voychenko-v/logger-stm32f401/hardware/Screenshot 2026-11-09 164255.png

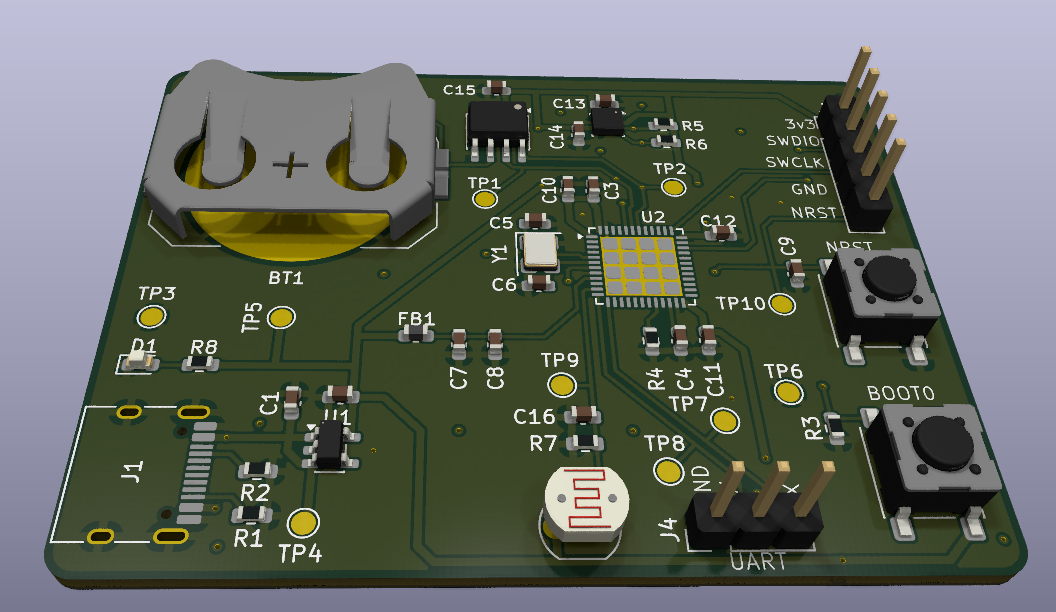
hardware/Screenshot 2026-11-09 164255.png
