voychenko-v/logger-stm32f401/hardware/env-logger.csv

Id | Designator | Footprint | Quantity | Designation | Supplier and ref
1 | BT1 | BatteryHolder_Keystone_3034_1x20mm | 1 | Battery_Cell
2 | C1, C2, C8 | C_0603_1608Metric | 3 | 1 мкФ
3 | C3, C7, C9, C10, C11, C12, C13, C14, C15, C16 | C_0603_1608Metric | 10 | 100 нФ
4 | C4 | C_0603_1608Metric | 1 | 2,2 мкФ
5 | C5, C6 | C_0603_1608Metric | 2 | 15 пФ
6 | D1 | LED_0603_1608Metric | 1 | LED
7 | FB1 | L_0603_1608Metric | 1 | FerriteBead
8 | J1 | USB_C_Receptacle_HRO_TYPE-C-31-M-12 | 1 | USB_C_USB2.0_14P
9 | J3 | PinHeader_1x05_P2.54mm_Vertical | 1 | Conn_01x05
10 | J4 | PinHeader_1x03_P2.54mm_Vertical | 1 | Conn_01x03
11 | R1, R2 | R_0603_1608Metric | 2 | 5,1 кОм
12 | R3, R4, R7 | R_0603_1608Metric | 3 | 10 кОм
13 | R5, R6 | R_0603_1608Metric | 2 | 4,7 кОм
14 | R8 | R_0603_1608Metric | 1 | 1 кОм
15 | R9 | R_LDR_5.0x4.1mm_P3mm_Vertical | 1 | GL5516
16 | SW1, SW2 | SW_SPST_PTS645Sx43SMTR92 | 2 | SW_Push
17 | TP1, TP2, TP3, TP4, TP5, TP6, TP7, TP8, TP9, TP10 | TestPoint_Pad_D1.5mm | 10 | TestPoint
18 | U1 | SOT-23-5 | 1 | AP2112K-3.3
19 | U2 | QFN-48-1EP_7x7mm_P0.5mm_EP5.6x5.6mm | 1 | STM32F401CCUx
20 | U3 | Bosch_LGA-8_2.5x2.5mm_P0.65mm_ClockwisePinNumbering | 1 | BME280
21 | U4 | SOIC-8_3.9x4.9mm_P1.27mm | 1 | DS3231MZ
22 | Y1 | Crystal_SMD_3225-4Pin_3.2x2.5mm | 1 | 25 МГц
