voychenko-v/logger-stm32f401/hardware/shematic.pdf

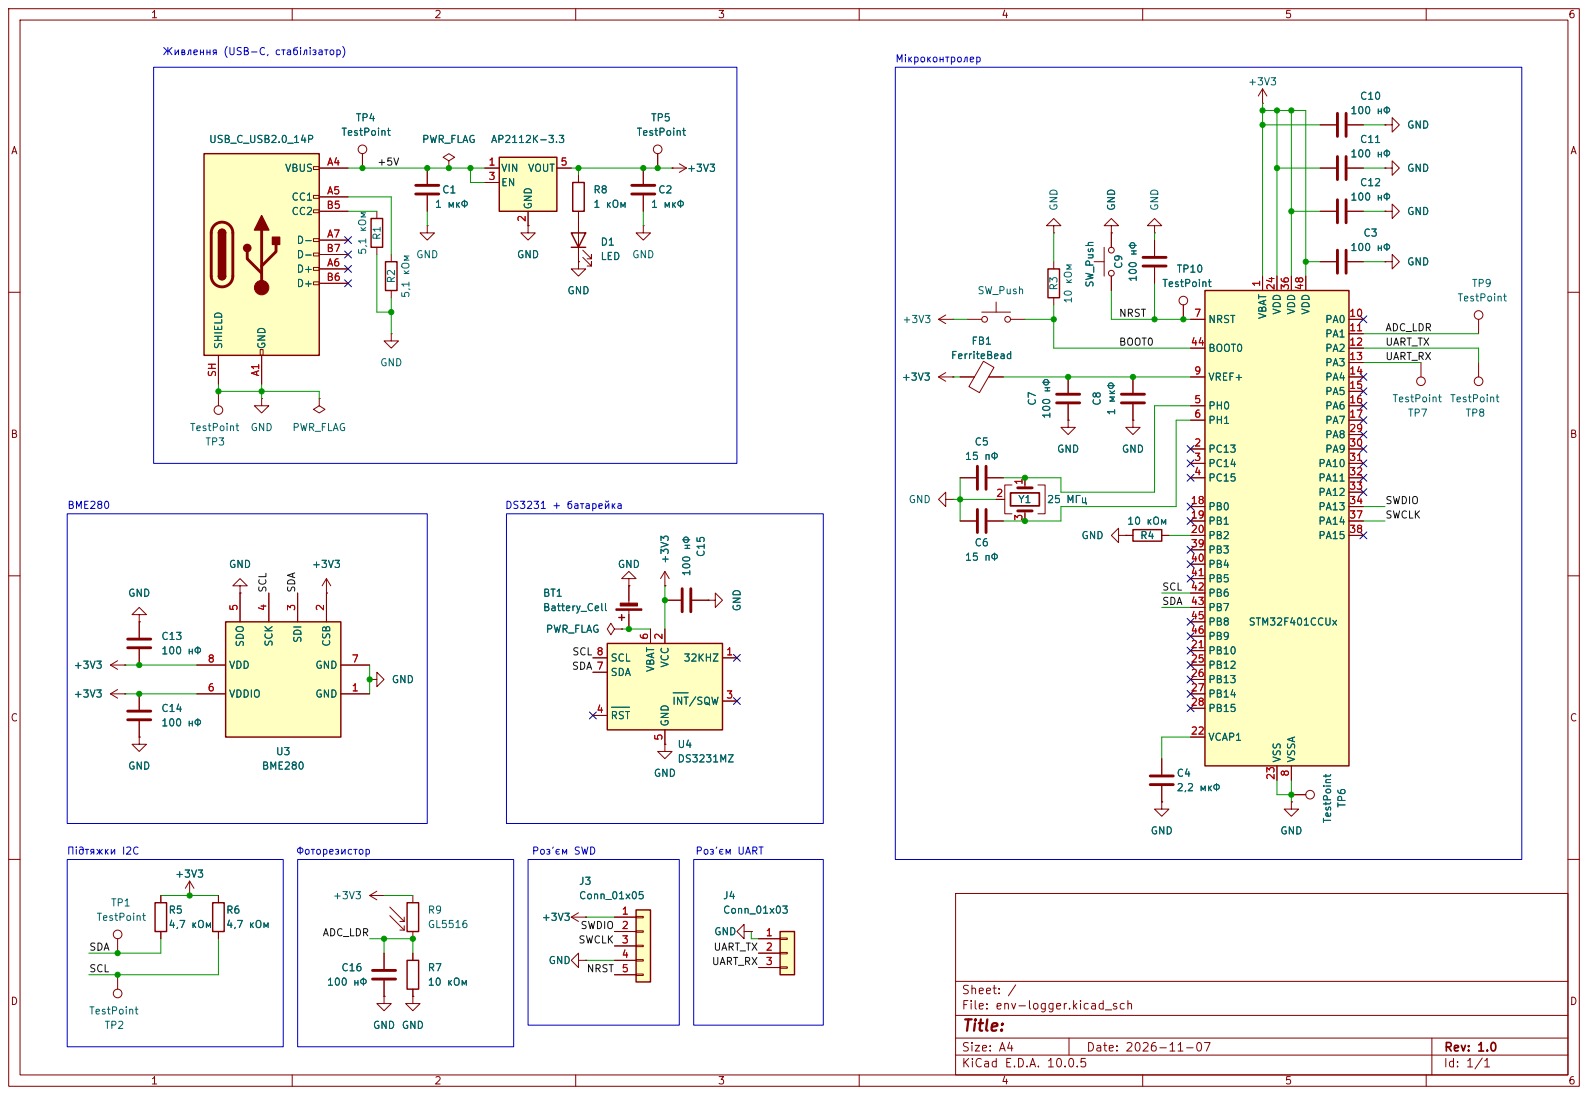
[picture p3: page 1]

Мікроконтролер Живлення (USB-C, стабілізатор)

SDA SCL

Size: A4 | Rev: 1.0
KiCad E.D.A. 10.0.5 | Id: 1/1
