voychenko-v/logger-stm32f401/hardware/env-logger-schematic.pdf

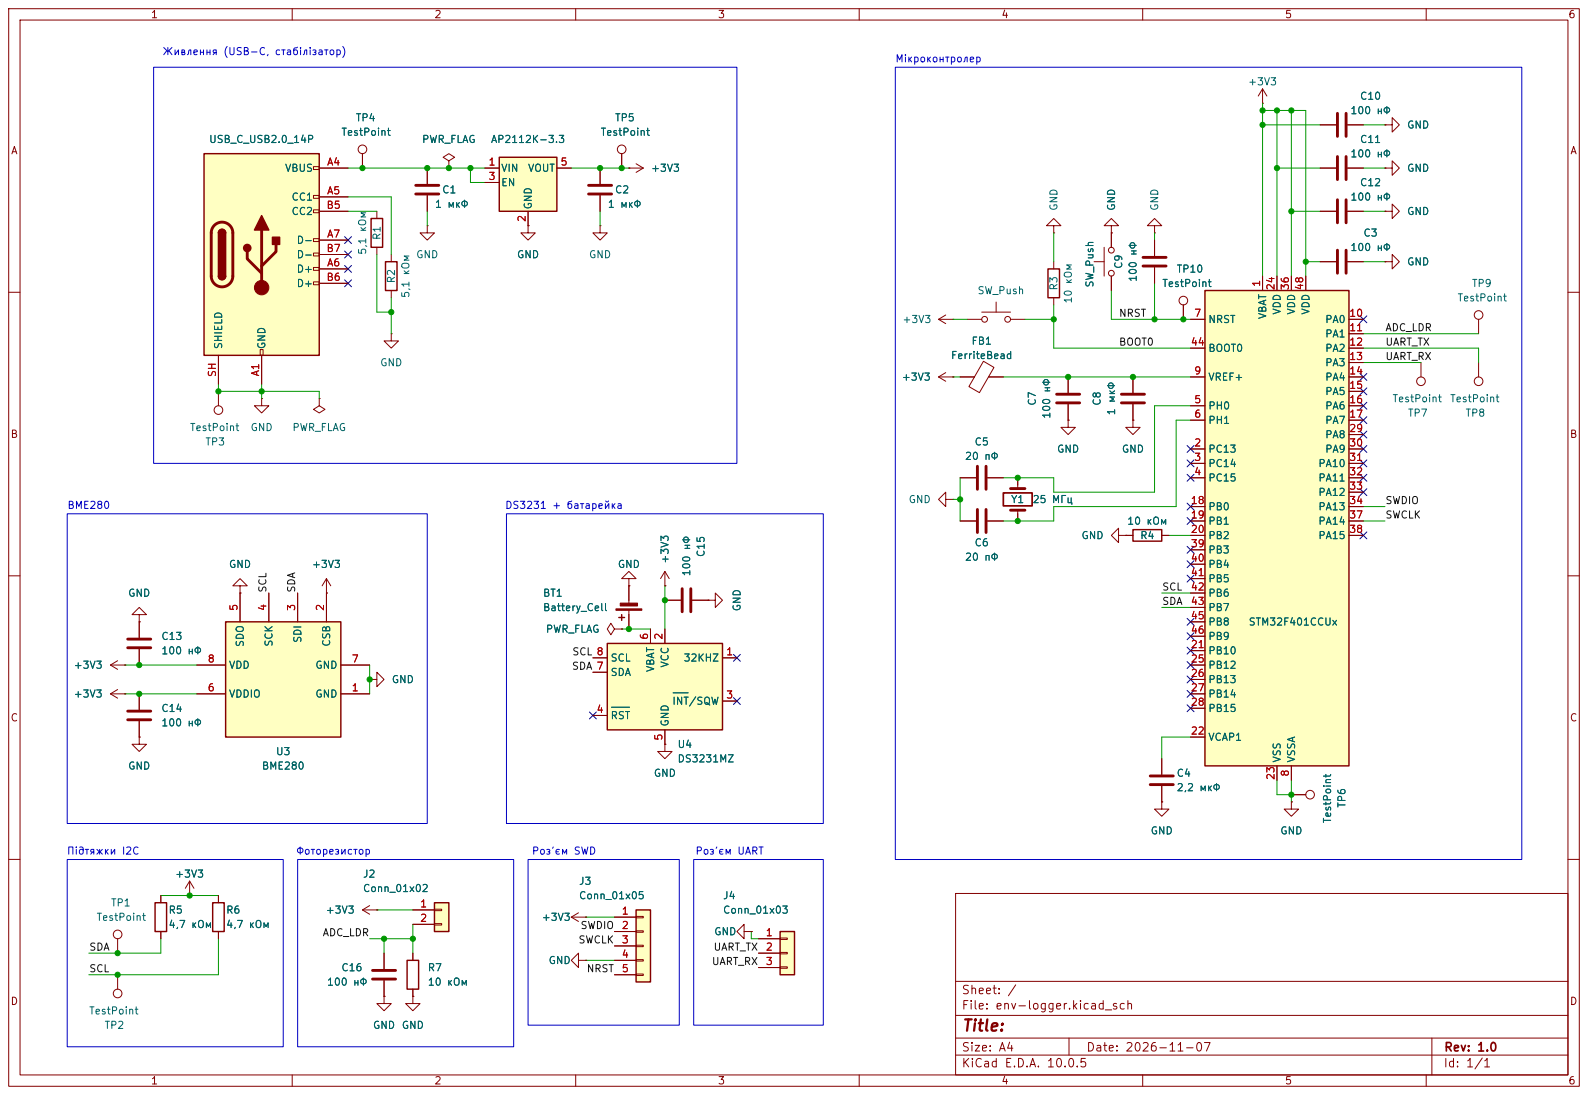
[picture p4: page 1]

Size: A4 | Rev: 1.0
KiCad E.D.A. 10.0.5 | Id: 1/1
