voychenko-v/logger-stm32f401/hardware/env-logger/env-logger.kicad_pcb

## KiCad design hardware/env-logger/env-logger.kicad_pcb (2026-11-10)

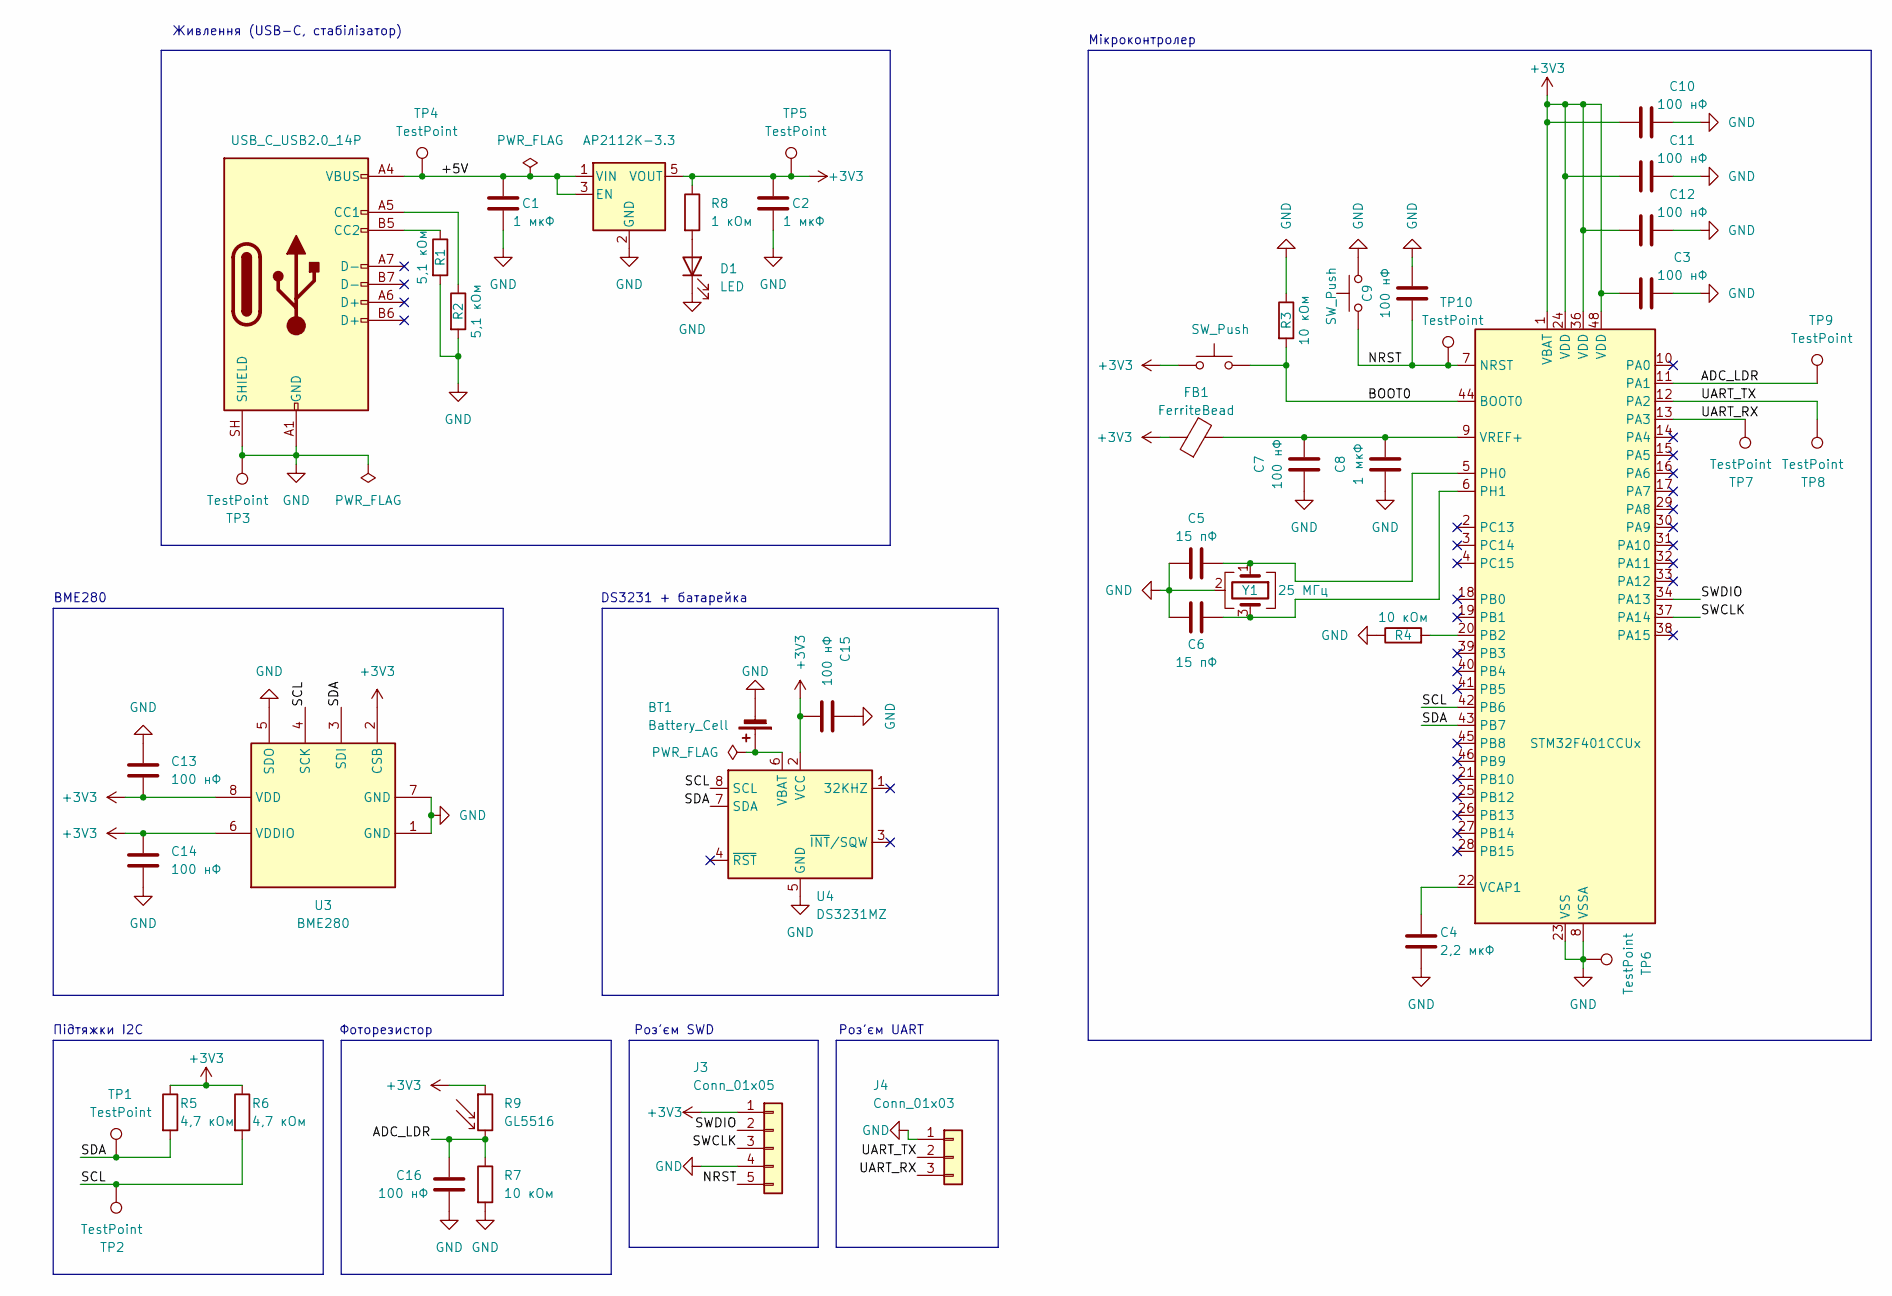
[picture p5: schematic env-logger.kicad_sch]

Parts:
BT1: Battery_Cell; BatteryHolder_Keystone_3034_1x20mm
C1, C2, C8: 1 мкФ; C_0603_1608Metric
C3, C7, C9, C10, C11, C12, C13, C14, C15, C16: 100 нФ; C_0603_1608Metric
C4: 2,2 мкФ; C_0603_1608Metric
C5, C6: 15 пФ; C_0603_1608Metric
D1: LED; LED_0603_1608Metric
FB1: FerriteBead; L_0603_1608Metric
J1: USB_C_USB2.0_14P; USB_C_Receptacle_HRO_TYPE-C-31-M-12
J3: Conn_01x05; PinHeader_1x05_P2.54mm_Vertical
J4: Conn_01x03; PinHeader_1x03_P2.54mm_Vertical
R1, R2: 5,1 кОм; R_0603_1608Metric
R3, R4, R7: 10 кОм; R_0603_1608Metric
R5, R6: 4,7 кОм; R_0603_1608Metric
R8: 1 кОм; R_0603_1608Metric
R9: GL5516; R_LDR_5.0x4.1mm_P3mm_Vertical
SW1, SW2: SW_Push; SW_SPST_PTS645Sx43SMTR92
TP1, TP2, TP3, TP4, TP5, TP6, TP7, TP8, TP9, TP10: TestPoint; TestPoint_Pad_D1.5mm
U1: AP2112K-3.3; SOT-23-5
U2: STM32F401CCUx; QFN-48-1EP_7x7mm_P0.5mm_EP5.6x5.6mm
U3: BME280; Bosch_LGA-8_2.5x2.5mm_P0.65mm_ClockwisePinNumbering
U4: DS3231MZ; SOIC-8_3.9x4.9mm_P1.27mm
Y1: 25 МГц; Crystal_SMD_3225-4Pin_3.2x2.5mm

Connections:
+3V3: C2.1, C3.1, C10.1, C11.1, C12.1, C13.2, C14.1, C15.2, FB1.1, J3.1, R5.1, R6.1, R8.1, R9.1, SW1.1, TP5.1 (1_1), U1.5 (VOUT), U2.1 (VBAT), U2.24 (VDD), U2.36 (VDD), U2.48 (VDD), U3.2 (CSB), U3.6 (VDDIO), U3.8 (VDD), U4.2 (VCC)
/+5V: C1.1, J1.A4 (VBUS), J1.A9 (VBUS), J1.B4 (VBUS), J1.B9 (VBUS), TP4.1 (1_1), U1.1 (VIN), U1.3 (EN)
/ADC_LDR: C16.1, R7.1, R9.2, TP9.1 (1_1), U2.11 (PA1)
/BOOT0: R3.2, SW1.2, U2.44 (BOOT0)
/NRST: C9.1, J3.5, SW2.1, TP10.1 (1_1), U2.7 (NRST)
/SCL: R6.2, TP2.1 (1_1), U2.42 (PB6), U3.4 (SCK), U4.8 (SCL)
/SDA: R5.2, TP1.1 (1_1), U2.43 (PB7), U3.3 (SDI), U4.7 (SDA)
/SWCLK: J3.3, U2.37 (PA14)
/SWDIO: J3.2, U2.34 (PA13)
/UART_RX: J4.3, TP7.1 (1_1), U2.13 (PA3)
/UART_TX: J4.2, TP8.1 (1_1), U2.12 (PA2)
GND: BT1.2 (-), C1.2, C2.2, C3.2, C4.2, C5.2, C6.2, C7.2, C8.2, C9.2, C10.2, C11.2, C12.2, C13.1, C14.2, C15.1, C16.2, D1.1 (K), J1.A1 (GND), J1.A12 (GND), J1.B1 (GND), J1.B12 (GND), J1.SH (SHIELD), J3.4, J4.1, R1.2, R2.2, R3.1, R4.1, R7.2, SW2.2, TP3.1 (1_1), TP6.1 (1_1), U1.2 (GND), U2.8 (VSSA), U2.23 (VSS), U2.35 (VSS), U2.47 (VSS), U2.49 (VSS), U3.1 (GND), U3.5 (SDO), U3.7 (GND), U4.5 (GND), Y1.2 (G), Y1.4 (G)
unnamed: BT1.1 (+), U4.6 (VBAT)
unnamed: D1.2 (A), R8.2
unnamed: J1.A5 (CC1), R2.1
unnamed: J1.B5 (CC2), R1.1
unnamed: R4.2, U2.20 (PB2)
unnamed: C5.1, U2.5 (PH0), Y1.1
unnamed: C6.1, U2.6 (PH1), Y1.3
unnamed: C4.1, U2.22 (VCAP1)
unnamed: C7.1, C8.1, FB1.2, U2.9 (VREF+)

Notes on the sheet:
Живлення (USB-C, стабілізатор)
Мікроконтролер
Роз'єм UART
DS3231 + батарейка
Роз'єм SWD
Підтяжки I2C
Фоторезистор
BME280

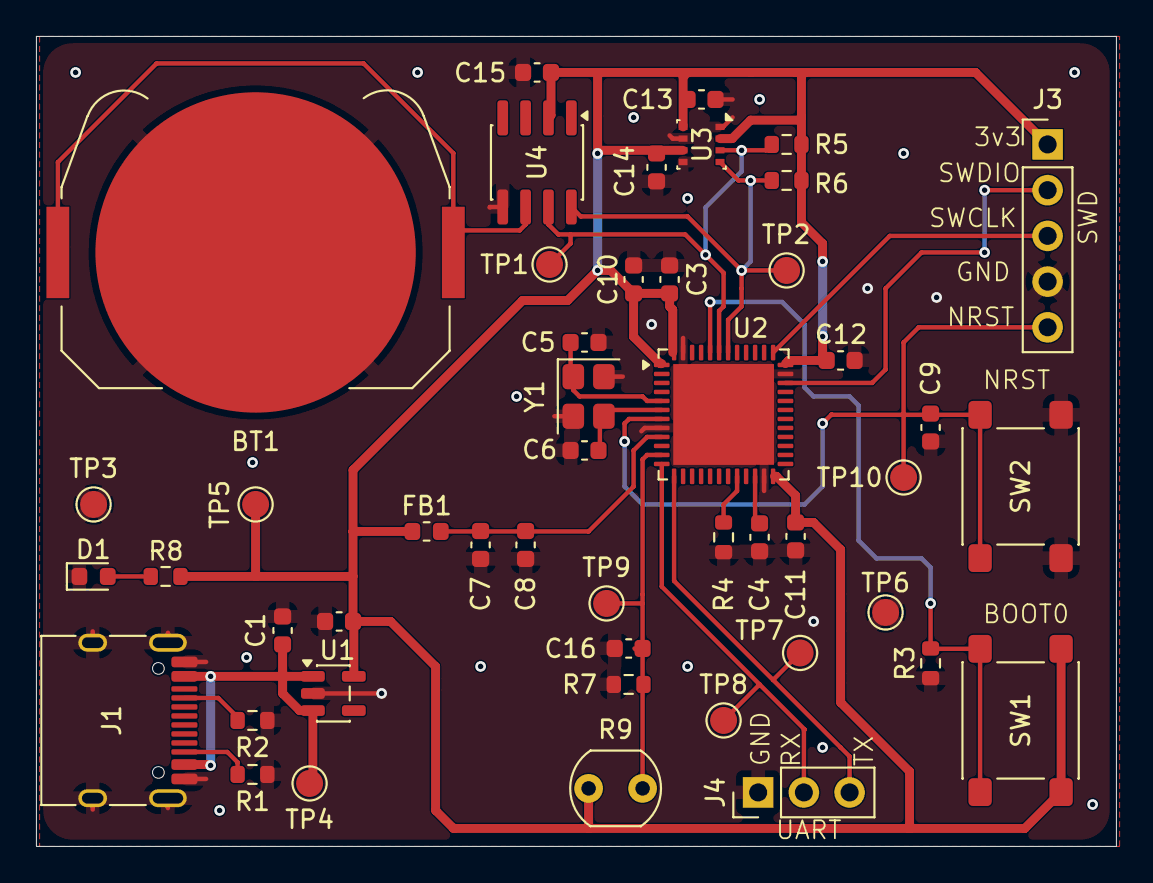
[picture p6: board env-logger.kicad_pcb from above]

Board: 2 copper layers, 60.0 x 45.0 mm, 48 parts (0 on the bottom side), 21 nets.
