voychenko-v/logger-stm32f401/Core/Src/main.c

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
/* Includes ------------------------------------------------------------------*/
#include "main.h"
#include "adc.h"
#include "dma.h"
#include "i2c.h"
#include "iwdg.h"
#include "tim.h"
#include "usart.h"
#include "gpio.h"

/* USER CODE BEGIN Includes */
#include <stdio.h>
#include "uart_log.h"
#include "i2c_bus.h"
#include "ds3231.h"
#include "bme280.h"
#include "logger.h"
#include "reset_info.h"
#include "watchdog.h"
#include "uart_rx.h"
#include "cli.h"
/* USER CODE END Includes */


void SystemClock_Config(void);
/**
  * @brief  The application entry point.
  * @retval int
  */
int main(void)
{

  /* MCU Configuration--------------------------------------------------------*/

  /* Reset of all peripherals, Initializes the Flash interface and the Systick. */
  HAL_Init();

  /* USER CODE BEGIN Init */
	__HAL_DBGMCU_FREEZE_IWDG();
  /* USER CODE END Init */

  /* Configure the system clock */
  SystemClock_Config();

  /* Initialize all configured peripherals */
  MX_GPIO_Init();
  MX_DMA_Init();
  MX_USART2_UART_Init();
  MX_TIM3_Init();
  MX_I2C1_Init();
  MX_IWDG_Init();
  MX_ADC1_Init();
  /* USER CODE BEGIN 2 */
	uart_log_init(&huart2);
	printf("\r\n=== Env Logger started ===\r\n");
	printf("SYSCLK = %lu Hz\r\n", HAL_RCC_GetSysClockFreq());
	printf("Reset reason: %s\r\n", reset_info_name(reset_info_get_and_clear()));

	watchdog_kick();
	i2c_bus_scan(&hi2c1);
	watchdog_kick();
	logger_init();
	uart_rx_init(&huart2);
	watchdog_kick();
	HAL_TIM_Base_Start_IT(&htim3);
  /* USER CODE END 2 */

  /* Infinite loop */
  /* USER CODE BEGIN WHILE */
	while (1) {
    /* USER CODE END WHILE */

    /* USER CODE BEGIN 3 */
		logger_task();
		cli_task();
		watchdog_kick();

	}
  /* USER CODE END 3 */
}

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
/* USER CODE BEGIN 4 */
void HAL_UART_TxCpltCallback(UART_HandleTypeDef *huart) {
	uart_log_on_tx_complete(huart);
}

void HAL_UART_RxCpltCallback(UART_HandleTypeDef *huart) {
	uart_rx_on_byte(huart);
}

void HAL_UART_ErrorCallback(UART_HandleTypeDef *huart) {
	uart_log_on_error(huart);
	uart_rx_on_error(huart);
}

void HAL_TIM_PeriodElapsedCallback(TIM_HandleTypeDef *htim) {
	if (htim->Instance == TIM3) {
	    logger_on_tick();
	}
}

/* USER CODE END 4 */
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
