voychenko-v/logger-stm32f401/logger-stm32f401.ioc

Mcu.UserName=STM32F401CCUx
PA1.Signal=ADCx_IN1
PA13.Signal=SYS_JTMS-SWDIO
PA14.Signal=SYS_JTCK-SWCLK
PA2.Signal=USART2_TX
PA3.Signal=USART2_RX
PB6.Signal=I2C1_SCL
PB7.Signal=I2C1_SDA
