voychenko-v/logger-stm32f401/Core/Inc/log_entry.h

#ifndef LOG_ENTRY_H
#define LOG_ENTRY_H

#include <stdint.h>
#include <stdbool.h>
#include "ds3231.h"


typedef struct {
    rtc_time_t ts;
    float      temp_c;
    float      hum_pct;
    float      press_hpa;
    float      lux;
    bool       lux_valid;
    uint32_t   err_cnt;
} log_entry_t;

#endif /* LOG_ENTRY_H */
