voychenko-v/logger-stm32f401/(commit log)

2026-10-24 chore: init CubeMX project for STM32F401CCU6 (clock 84MHz, SWD)
2026-10-24 feat: add UART2 logging via printf (115200 8N1)
2026-10-26 feat: add I2C1 400kHz and bus scanner
2026-10-26 feat: add DS3231 RTC driver with BCD handling and validation
2026-10-26 feat: add BME280 driver (forced mode, integer compensation, validity checks)
2026-10-29 feat: async UART TX via ring buffer and DMA
2026-10-30 feat: I2C error recovery (retry x3, bus recovery, sensor reinit), logger owns sensor init
2026-11-01 feat: add GL5516 light sensor via ADC1 + DMA circular, fault detection, lux in log
2026-11-01 feat: UART RX ring buffer and CLI (settime, interval, errclr, status), input validation
2026-11-06 feat: add KiCad project env-logger in hardware/ (schematic, PCB), KiCad gitignore rules
2026-11-07 hardware: add KiCad schematic with test points
2026-11-07 hardware: finalize schematic (crystal, footprints pending)
2026-11-09 hardware: schematic with power LED, +5V label, 2.54mm headers
2026-11-09 hardware: finish PCB, add fabrication outputs and renders
2026-11-09 Rename Screenshot 2026-11-09 164255.png to PCB_3D.png
2026-11-10 docs: add PCB section, prototype vs board, update structure and status
2026-11-12 docs: add presentation PDF for Logger STM32F401
